Ezcal/ece411/README.md

# ece411
Practicum Project for ECE411 - Fall 2015
### Team Name: Sagutinhoun
### Group members:
Miguel Garcia de los Santos, Sabin Maharjan, Christina Nelson, and Calhoun Zabel
