Ezcal/ece411/eagle/Digital_Level_Mainboard_T01_v2.brd

## EAGLE design eagle/Digital_Level_Mainboard_T01_v2.brd (2015-11-13)

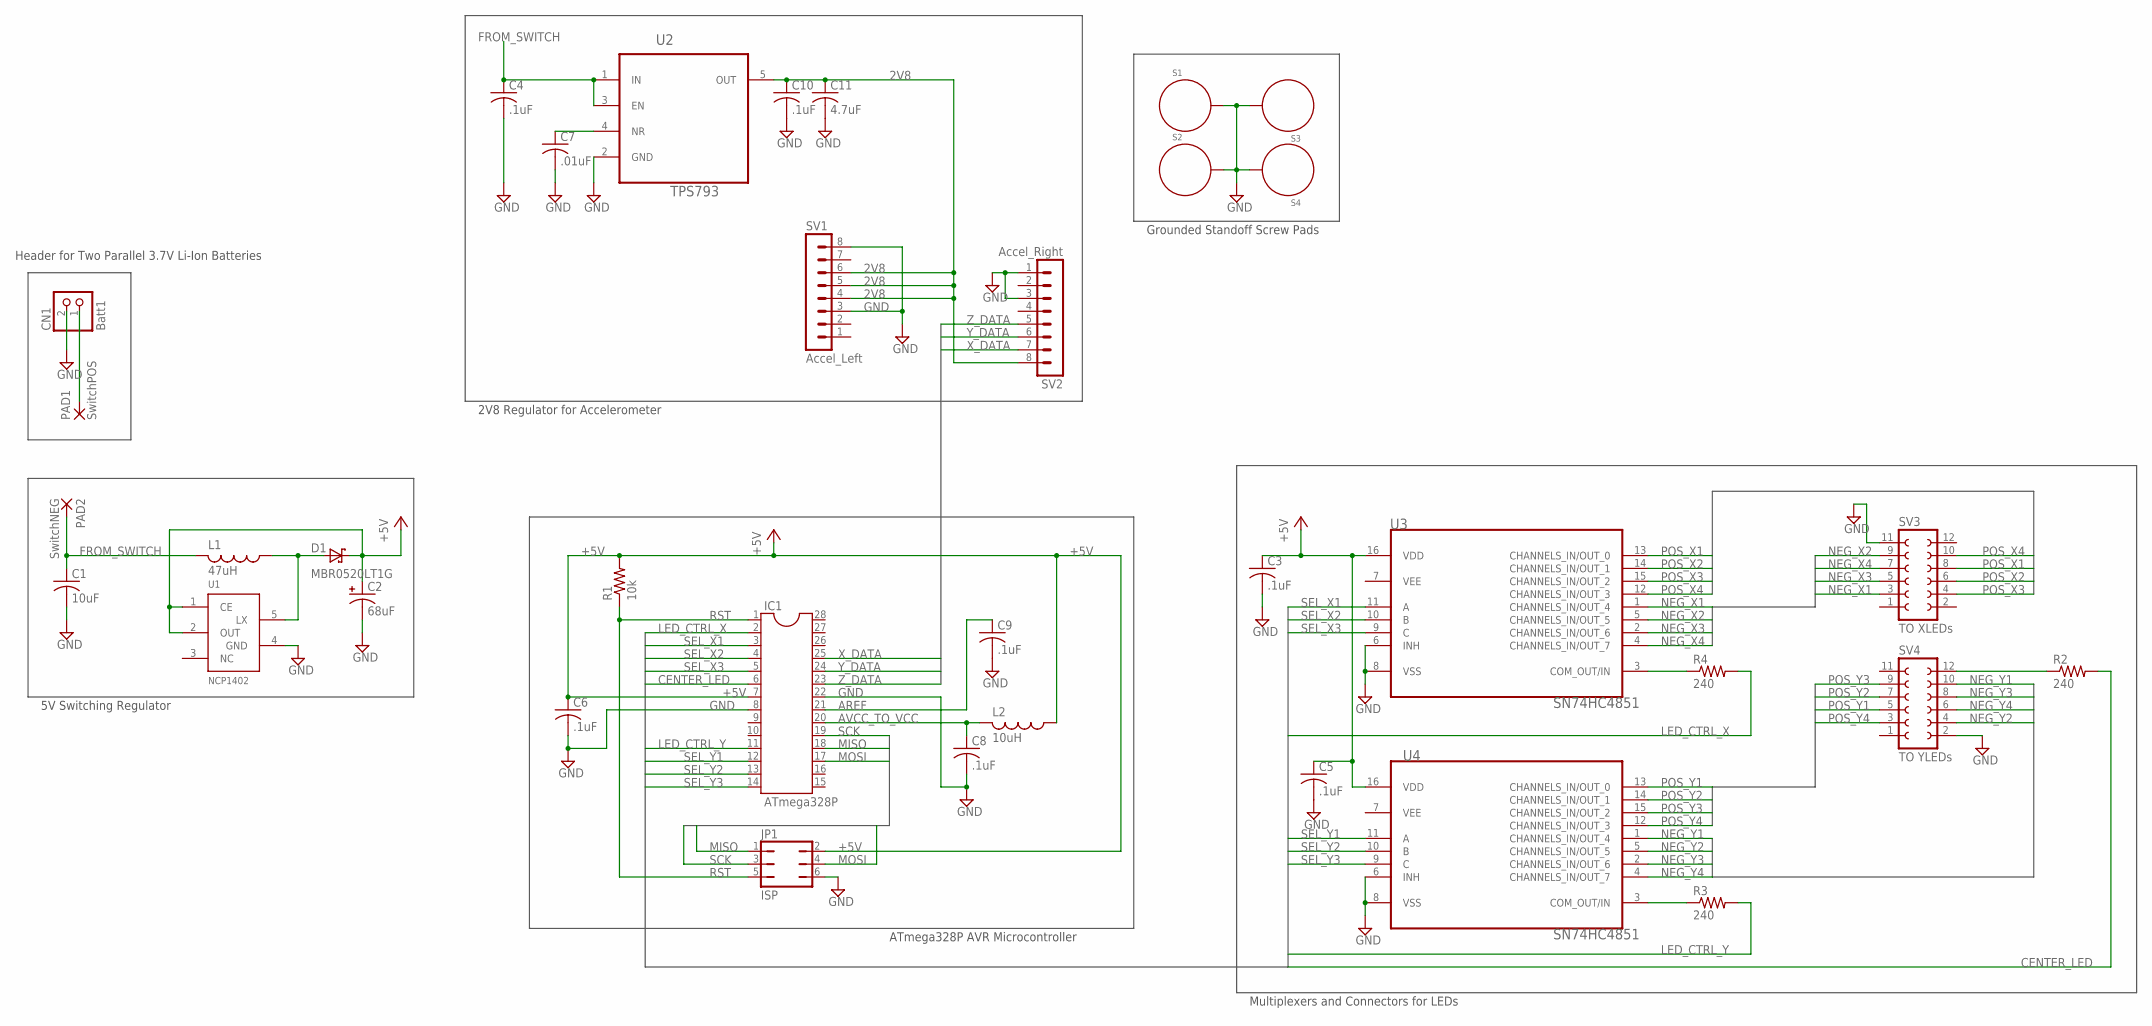
[picture p1: schematic Digital_Level_Mainboard_T01_v2.sch]

Parts:
C1: 10uF; C1206K
C2: 68uF; 2312_CAP
C3, C4, C5, C6, C8, C9, C10: .1uF; C1206K
C7: .01uF; C1206K
C11: 4.7uF; C1206K
CN1: Batt1; JST-PH-2-SMT
D1: MBR0520LT1G; MBR0520
IC1: ATmega328P; DIL28-3
JP1: ISP; JP3Q
L1: 47uH; BOURNS_INDUCTOR
L2: 10uH; L1812
PAD1: SwitchPOS; 2,54/1,1
PAD2: SwitchNEG; 2,54/1,1
R1: 10k; R0805
R2, R3, R4: 240; R1206
S1, S2, S3, S4: STANDOFF_ELECTRICAL; STANDOFF-ELECTRICAL
SV1: Accel_Left; MA08-1
SV2: Accel_Right; MA08-1
SV3: TO XLEDs; FE06-2
SV4: TO YLEDs; FE06-2
U1: NCP1402; WSON-8
U2: TPS793; SOT95P280X145-5N
U3, U4: SN74HC4851; DIP254P762X508-16

Connections:
2V8: C10.1, C11.1, SV1.4, SV1.5, SV1.6, SV2.8, U2.5 (OUT)
5V_REG1_LX: D1.P$2 (A), L1.P$1 (1), U1.5 (LX)
+5V: C2.P (1), C3.1, C5.1, C6.1, D1.P$1 (K), IC1.7, JP1.2, L2.1, R1.2, U1.1 (CE), U1.2 (OUT), U3.16 (VDD), U4.16 (VDD)
AREF: C9.1, IC1.21
AVCC_TO_VCC: C8.1, IC1.20, L2.2
CENTER_LED: IC1.6, R2.2
CENTER_LED_CONN: R2.1, SV4.12
CTRL_X_TO_MUX: R4.1, U3.3 (COM_OUT/IN)
CTRL_Y_TO_MUX: R3.1, U4.3 (COM_OUT/IN)
FROM_SWITCH: C1.1, C4.1, L1.P$2 (2), PAD2.1, U2.1 (IN), U2.3 (EN)
GND: C1.2, C2.N (2), C3.2, C4.2, C5.2, C6.2, C7.2, C8.2, C9.2, C10.2, C11.2, CN1.2 (1), IC1.8, IC1.22, JP1.6, S1.P1, S2.P1, S3.P1, S4.P1, SV1.3, SV1.8, SV2.1, SV2.3, SV3.11, SV4.2, U1.4 (GND), U2.2 (GND), U3.6 (INH), U3.8 (VSS), U4.6 (INH), U4.8 (VSS)
LED_CTRL_X: IC1.2, R4.2
LED_CTRL_Y: IC1.11, R3.2
LIN-REG_NR-PIN: C7.1, U2.4 (NR)
MISO: IC1.18, JP1.1
MOSI: IC1.17, JP1.4
NEG_X1: SV3.3, U3.1 (CHANNELS_IN/OUT_4)
NEG_X2: SV3.9, U3.5 (CHANNELS_IN/OUT_5)
NEG_X3: SV3.5, U3.2 (CHANNELS_IN/OUT_6)
NEG_X4: SV3.7, U3.4 (CHANNELS_IN/OUT_7)
NEG_Y1: SV4.10, U4.1 (CHANNELS_IN/OUT_4)
NEG_Y2: SV4.4, U4.5 (CHANNELS_IN/OUT_5)
NEG_Y3: SV4.8, U4.2 (CHANNELS_IN/OUT_6)
NEG_Y4: SV4.6, U4.4 (CHANNELS_IN/OUT_7)
POS_BATT: CN1.1 (2), PAD1.1
POS_X1: SV3.8, U3.13 (CHANNELS_IN/OUT_0)
POS_X2: SV3.6, U3.14 (CHANNELS_IN/OUT_1)
POS_X3: SV3.4, U3.15 (CHANNELS_IN/OUT_2)
POS_X4: SV3.10, U3.12 (CHANNELS_IN/OUT_3)
POS_Y1: SV4.5, U4.13 (CHANNELS_IN/OUT_0)
POS_Y2: SV4.7, U4.14 (CHANNELS_IN/OUT_1)
POS_Y3: SV4.9, U4.15 (CHANNELS_IN/OUT_2)
POS_Y4: SV4.3, U4.12 (CHANNELS_IN/OUT_3)
RST: IC1.1, JP1.5, R1.1
SCK: IC1.19, JP1.3
SEL_X1: IC1.3, U3.11 (A)
SEL_X2: IC1.4, U3.10 (B)
SEL_X3: IC1.5, U3.9 (C)
SEL_Y1: IC1.12, U4.11 (A)
SEL_Y2: IC1.13, U4.10 (B)
SEL_Y3: IC1.14, U4.9 (C)
X_DATA: IC1.25, SV2.7
Y_DATA: IC1.24, SV2.6
Z_DATA: IC1.23, SV2.5

Notes on the sheet:
Header for Two Parallel 3.7V Li-Ion Batteries
5V Switching Regulator
2V8 Regulator for Accelerometer
Grounded Standoff Screw Pads
Multiplexers and Connectors for LEDs
ATmega328P AVR Microcontroller

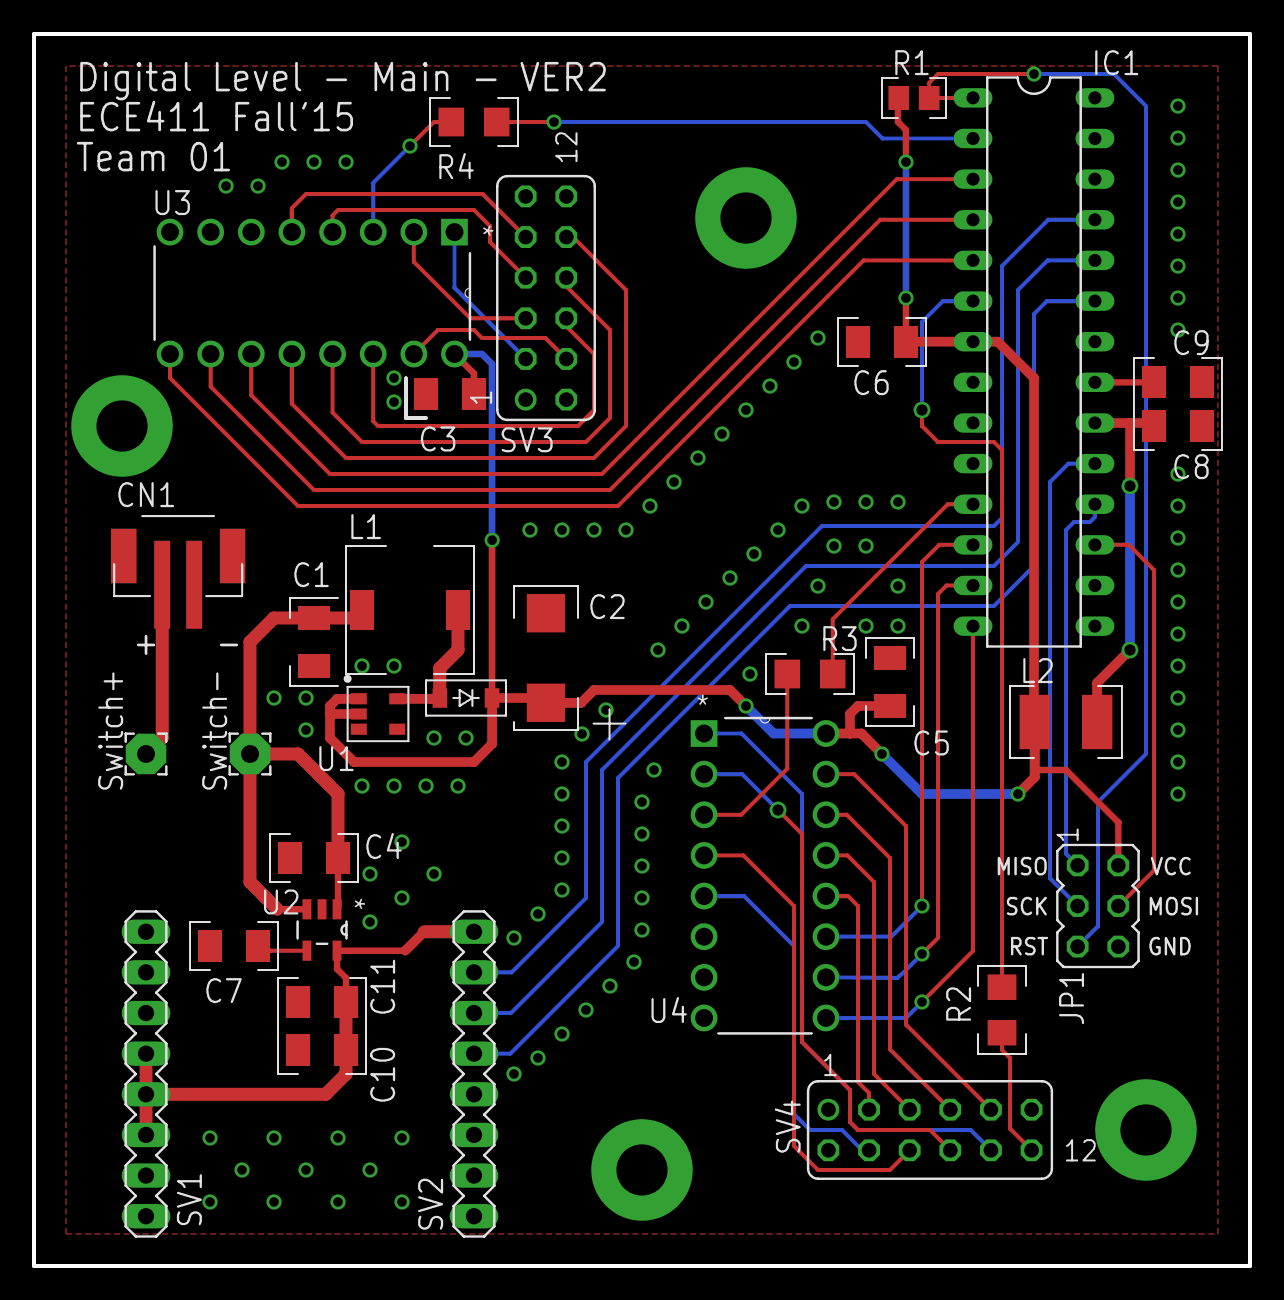
[picture p2: board Digital_Level_Mainboard_T01_v2.brd from above]

Board: 2 copper layers, 76.0 x 77.0 mm, 35 parts (0 on the bottom side), 44 nets.
