Ezcal/ece411/eagle/Digital_Level_LEDboard_T01_v2.brd

## EAGLE design eagle/Digital_Level_LEDboard_T01_v2.brd (2015-11-13)

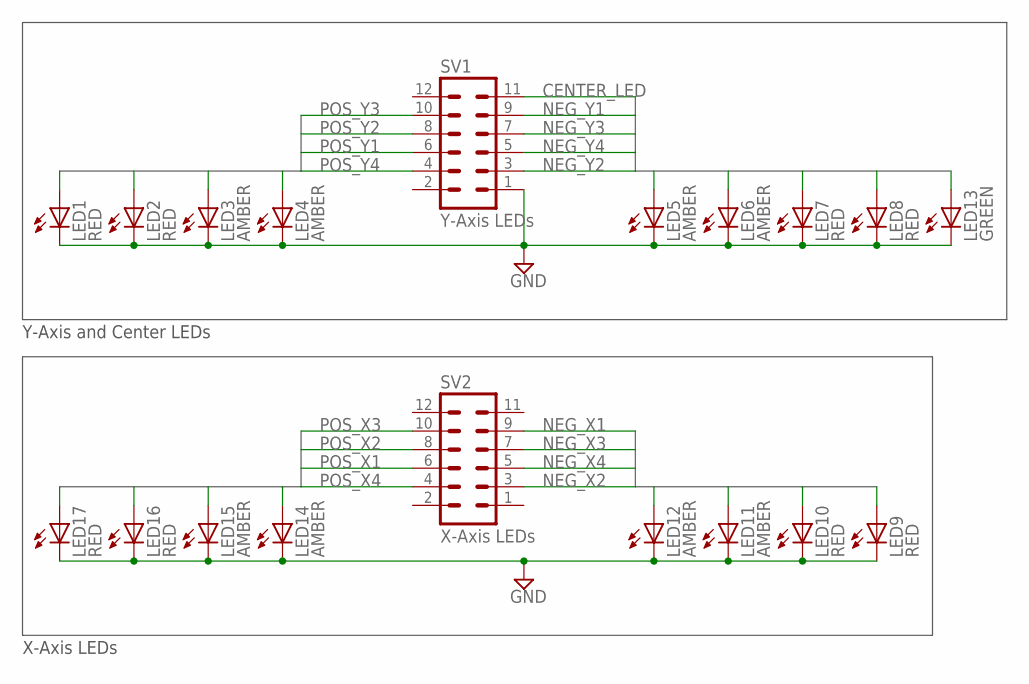
[picture p3: schematic Digital_Level_LEDboard_T01_v2.sch]

Parts:
LED1, LED2, LED7, LED8, LED9, LED10, LED16, LED17: RED; LED5MM
LED3, LED4, LED5, LED6, LED11, LED12, LED14, LED15: AMBER; LED5MM
LED13: GREEN; LED5MM
SV1: Y-Axis LEDs; MA06-2
SV2: X-Axis LEDs; MA06-2

Connections:
CENTER_LED: LED13.A, SV1.11
GND: LED1.K (C), LED2.K (C), LED3.K (C), LED4.K (C), LED5.K (C), LED6.K (C), LED7.K (C), LED8.K (C), LED9.K (C), LED10.K (C), LED11.K (C), LED12.K (C), LED13.K (C), LED14.K (C), LED15.K (C), LED16.K (C), LED17.K (C), SV1.1
NEG_X1: LED12.A, SV2.9
NEG_X2: LED11.A, SV2.3
NEG_X3: LED10.A, SV2.7
NEG_X4: LED9.A, SV2.5
NEG_Y1: LED5.A, SV1.9
NEG_Y2: LED6.A, SV1.3
NEG_Y3: LED7.A, SV1.7
NEG_Y4: LED8.A, SV1.5
POS_X1: LED14.A, SV2.6
POS_X2: LED15.A, SV2.8
POS_X3: LED16.A, SV2.10
POS_X4: LED17.A, SV2.4
POS_Y1: LED4.A, SV1.6
POS_Y2: LED3.A, SV1.8
POS_Y3: LED2.A, SV1.10
POS_Y4: LED1.A, SV1.4

Notes on the sheet:
Y-Axis and Center LEDs
X-Axis LEDs

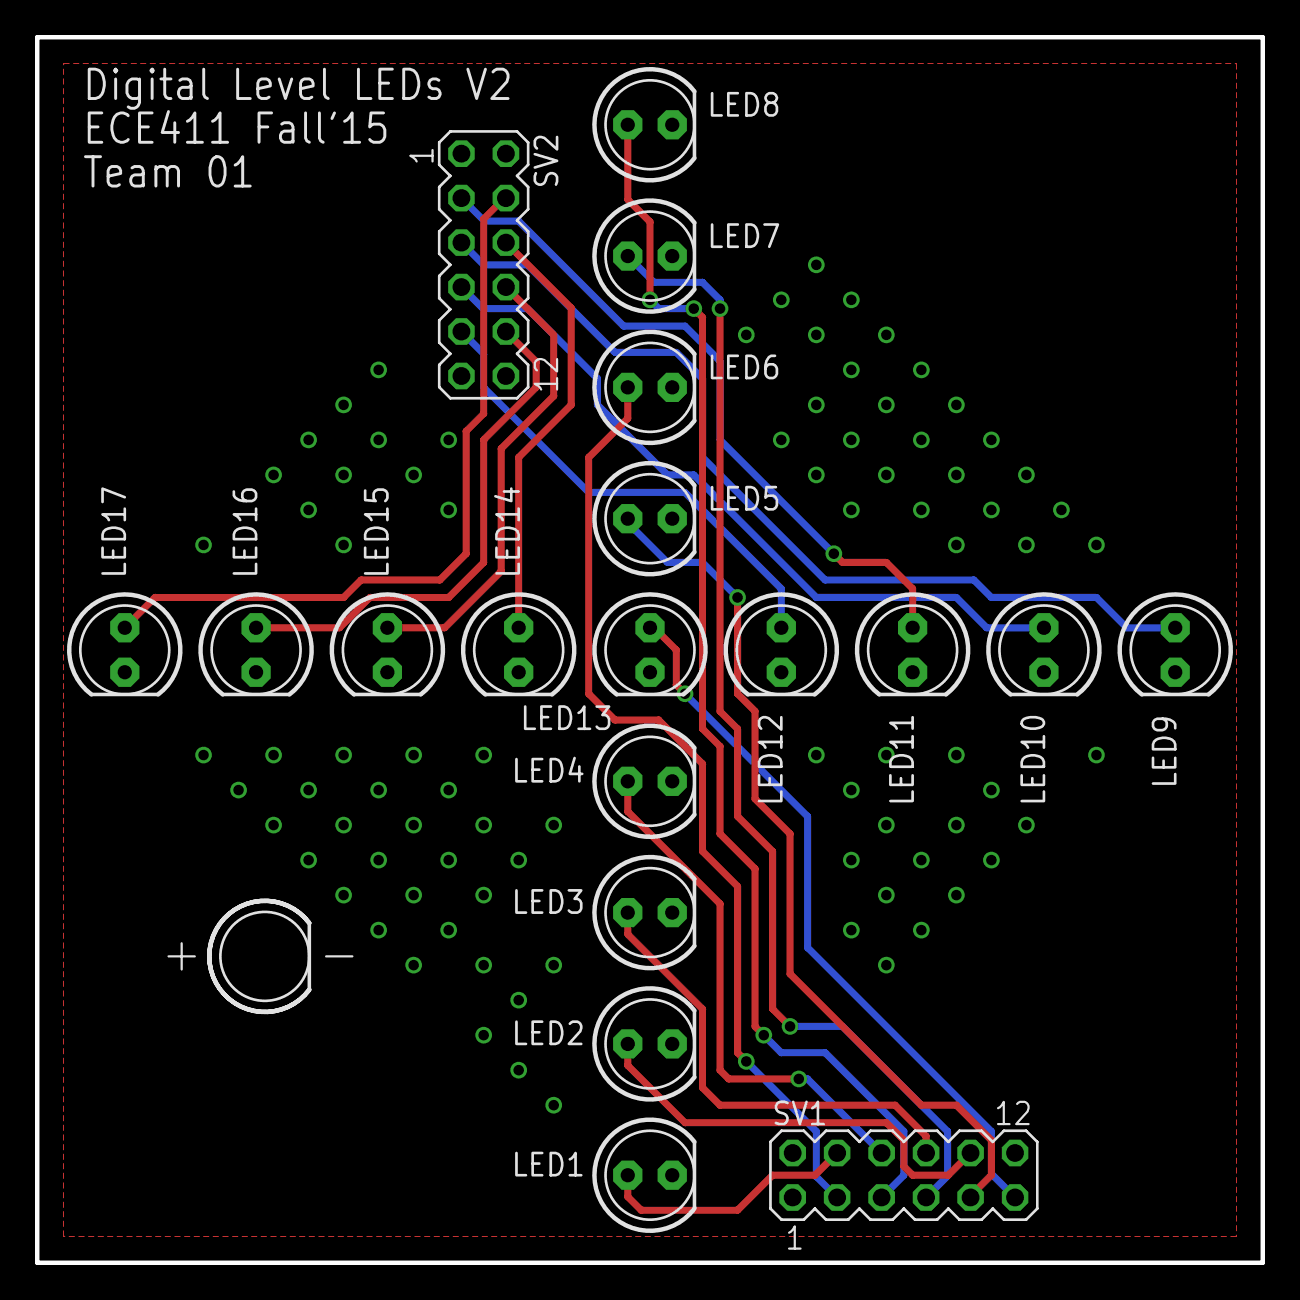
[picture p4: board Digital_Level_LEDboard_T01_v2.brd from above]

Board: 2 copper layers, 70.0 x 70.0 mm, 19 parts (0 on the bottom side), 18 nets.
