Ezcal/ece411/(threads)

Thread 3 (2015-10-08):

Paragraph for Fingerprint Door Lock

Ezcal, 2015-10-08:
Descriptive paragraph for project idea to put in main proposal.

cnels2, 2015-10-10:
In the Fingerprint Door Lock design, only authorized users are permitted access to a locked room. A user’s fingerprints are initially scanned and recorded onto the fingerprint sensor. When the user wants to access a room, they will scan their fingerprint again, thus creating a second image to compare to the original. The unique patterns of each fingerprint are analyzed and determined if there is a match. The fingerprint sensor is connected to a microcontroller. If the fingerprint image matches the original, the microcontroller will send a signal to a solenoid. The energized solenoid will unlock and the user will be allowed access to the room.

Closed 2015-10-12.

Thread 4 (2015-10-08):

Paragraph for Heartbeat Sensor Project

Ezcal, 2015-10-08:
Descriptive paragraph for project idea to put in main proposal.

sabmah, 2015-10-09:
Pulse sensor will use infrared emitter and detector to get the pulse from the finger tip.
Couple of ways to display the data:
1. Cascade of seven segment display.
2. Graphic wave monitor

Closed 2015-10-12.

Thread 5 (2015-10-08):

Paragraph for Laser Tripwire

Ezcal, 2015-10-08:
Descriptive paragraph for project idea to put in main proposal.

mgarcia2, 2015-10-12:
Team #Sagutinhoun will design and build a Laser Tripwire Alarm that detects objects that cross the laser beam using a photoresistor. If the beam was crossed then the alarm will go off using a speaker. This will be controlled using the Atmel ATMegaXXXX.

Closed 2015-10-12.

Thread 6 (2015-10-08):

Project Requirements

Ezcal, 2015-10-08:
Requirements
● Requirements ≠ Specifications
● General description of the system - no numbers, no specifics
● User stories!
● Questions like:
○ What does it do?
○ How does it get used?
○ Who uses it?
○ What does it look like?
○ What is novel/interesting about this concept?
○ What aspects of it are important?
● Note that none of these are ”How does it work?”

Requirements Examples
● “Collar must track dog and report dog’s position and whether the dog is rolling
in something”
● “Should fit on most dogs”
● “Must be water proof”
● “Should last all day”
● “Must safe”
● User story: “User clips collar on small dog. User turns on the collar. User lets
the dog outside. User goes to their computer and brings up website, which
has the live track of the dog. User runs outside screaming at dog when it rolls
on something.”

Thread 8 (2015-10-26):

Image Uploads

Ezcal, 2015-10-26:
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

Ezcal, 2015-10-28:
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

Ezcal, 2015-11-04:
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

Ezcal, 2015-11-04:
[Digital_Level_Mainboard_T01.pdf](https://github.com/Ezcal/ece411/files/27589/Digital_Level_Mainboard_T01.pdf)
[Digital_Level_LEDboard_T01.pdf](https://github.com/Ezcal/ece411/files/27590/Digital_Level_LEDboard_T01.pdf)

Ezcal, 2015-11-04:
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

Ezcal, 2015-11-12:
[Digital_Level_Mainboard_T01_v2.pdf](https://github.com/Ezcal/ece411/files/33296/Digital_Level_Mainboard_T01_v2.pdf)

Ezcal, 2015-11-12:
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

Ezcal, 2015-11-13:
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

Ezcal, 2015-11-25:
[Digital Level Test Plan v1.2.docx](https://github.com/Ezcal/ece411/files/44059/Digital.Level.Test.Plan.v1.2.docx)

Ezcal, 2015-12-08:
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
