Ezcal/ece411/(commit log)

2015-10-20 Schematic
    Current 10/19/2015
    [Digital_Level_AccelBrkout_PDIP_AVR.sch]
2015-10-21 Latest Schematic
    [Digital_Level_AccelBrkout_PDIP_AVR.sch]
2015-10-26 Create ADC
2015-10-27 Update ADC
2015-10-28 Updated Schematic
    [Digital_Level_AccelBrkout_PDIP_AVR.sch]
2015-11-10 Update DigitalLevel.c
    fixed some bug
    [DigitalLevel.c]
2015-11-13 Adding eagle files and directory
    [Digital_Level_LEDboard_T01_v2.brd, Digital_Level_LEDboard_T01_v2.sch, Digital_Level_Mainboard_T01_v2.brd, Digital_Level_Mainboard_T01_v2.sch]
2015-11-15 New code by Cal
    New code using the internal 1.1V reference, and blocking center LED when
    either axis is off-centered
